AcheronProject/Apollo87H/(threads)

Thread 2 (2021-05-20):

Is this an A87 form factor?

dhanakane, 2021-05-20:
I’m hoping to use this as a drop in replacement for an H87c. Would it be suitable for this?

Gondolindrim, 2021-05-22:
Hello,

It was designed to be a replacement to H87/A87 PCBs. Please note that the compatibility list is still limited and I cannot guarantee fitness for a particular product (please read the license).

dhanakane, 2021-05-23:
Thank you. If you’ve got any tips on how to check for theoretical fit then that would be much appreciated. I’m assuming I can open up the PCB file in something like FreeCAD and look at the dimensions?

If the PCB footprint is the same as an H87, then it should work for my use case. Obviously, I understand this is all at my own risk.

Thanks for putting this project out there. I really appreciate the work!

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

Gondolindrim, 2021-05-25:
Confirmedly fits F1-84 by Geonworks

Gondolindrim, 2021-06-08:
> Thank you. If you’ve got any tips on how to check for theoretical fit then that would be much appreciated. I’m assuming I can open up the PCB file in something like FreeCAD and look at the dimensions?

> If the PCB footprint is the same as an H87, then it should work for my use case. Obviously, I understand this is all at my own risk.

> Thanks for putting this project out there. I really appreciate the work!

No problem!

There will be STEP files released soon, I just haven't had time to look at the weird error some of the LED footprints are giving me. If you have a 3D model of your case you should be able to test with the STEP if the PCB fits.

dhanakane, 2021-07-03:
Unfortunately I'm just a consumer and not a case designer. I'd be willing to order a prototype if the files to do so (gerber?) are made available, at my own risk obviously :)

Gondolindrim, 2021-07-04:
Prototypes for Apollo87H were already ordered -- if you'd like, you could order protos for Athena (solderable version of Apollo).

dhanakane, 2021-07-04:
Happy to do so if you can point me at the repo and files?

On Sun, 4 Jul 2021 at 20:58, Álvaro A. Volpato ***@***.***>
wrote:

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

Gondolindrim, 2021-07-08:
Athena is mid-development and I plan to release it by the end of the month.

Gondolindrim, 2022-05-17:
Closing this as prototypes were ordered and this PCB and Athena are confirmed H87 replacements.

Closed 2022-05-17.

Thread 4 (2025-08-19):

[PCB] Apollo87HL-T-SC 7u FR-4 Gray/1.6mm - No MT() Functionality in VIA

sleepbelts, 2025-08-19:
No MT() support in provided VIA firmware

Gondolindrim, 2025-08-20:
QMK documentation does not determine any particular firmware afjustment to make mod-tap enabled, so it should be fine... Can you reach me over at discord?

Closed 2025-08-20.
