AcheronProject/Apollo87H/(commit log)

2021-02-13 nAdded and routed RGB
    [apollo87h.kicad_sch]
2021-02-15 Routed SWD
    [apollo87h.kicad_sch]
2021-02-15 Advance routing
    [apollo87h.kicad_sch]
2021-02-16 DRC ran, issues fixed. Revised edges and pads to fit hoswap sockets better
    [apollo87h.kicad_sch]
2021-02-16 Finished routing, metadata update pending
    [apollo87h.kicad_sch]
2021-02-16 Added metadata to components
    [apollo87h.kicad_sch]
2021-02-16 Added label
    [apollo87h.kicad_sch]
2021-02-17 Added metadata for sheet and hotswap sockets
    [apollo87h.kicad_sch]
2021-02-17 Added Acheron Logo, minor trace adjustmentand no-net zones adjustments
    [apollo87h.kicad_sch]
2021-02-18 Preparing for release. Removed 'remove from bom' for hotswap sockets
    [apollo87h.kicad_sch]
2021-02-19 New KiCad version, first README version, Apollo logo added to resources
2021-03-05 Detachable USBC, JST connector
    [apollo87h.kicad_sch]
2021-03-17 Add HS standoffs for plate
    [apollo87h.kicad_sch]
2021-03-25 QOL upgrades
    - USB shielding ferrite bead was moved near the case grounding pad so as to make the ground copper pour more solid
    - Added extra RGB daugtherboard connector and a cable notch for passing the cable through
    - Added mechanical mousebit holes to make the USBC connector removable
    - Ran DRC, corrected minor errors
    [apollo87h.kicad_sch]
2021-03-25 Organize schematic
    [apollo87h.kicad_sch]
2021-03-25 Add specification metadata to components
    [apollo87h.kicad_sch]
2021-03-26 Remove 87HS file
    [apollo87h.kicad_sch]
2021-03-26 Cleanup for new RGB
    [apollo87h.kicad_sch]
2021-03-26 Setup RGB chip
    [apollo87h.kicad_sch]
2021-03-27 Place some LEDs, route some cols
    [apollo87h.kicad_sch]
2021-03-27 Add logo, reroute columns
    [apollo87h.kicad_sch]
2021-03-28 RGB routing
    [apollo87h.kicad_sch]
2021-03-28 Start routing RGB
    [apollo87h.kicad_sch]
2021-03-29 Add gitignore, more routing
    [apollo87h.kicad_sch]
2021-03-30 More RGB routing
    [apollo87h.kicad_sch]
2021-03-31 Further RGB routing
    [apollo87h.kicad_sch]
2021-04-01 Further RGB, 5V and 3V3 routing¨
    [apollo87h.kicad_sch]
2021-04-14 Features and QOL changes
    - Routed columns C14-C16
    - Added RGB daugherboard connector, routed RGB underglow circuit, and notch (hole) for RGB JST cable connection
    - Routed SWD pins and reset circuit
    - Changed RGB chip footprint to version with thermal relief vias on thermal pad
    - Routed bottom columns
    - Solved instances of unconnected traces
    - Exposed extra non-used pins
    - Made RGB chip unused pins floating and removed resistors
    [apollo87h.kicad_sch]
2021-04-16 Finish routing and run DRC
    - DRC ran, errors corrected
    - Routed column pins of the bottommost row RGB LEDs
    - Reorganized schematic
    - Changed RGB resistors for red LEDs to 51R
    - Filled void ground fill islands
    [apollo87h.kicad_sch]
2021-04-19 Change standoffs to 3.5mm tall version
    [apollo87h.kicad_sch]
2021-04-19 Added revision beta label
    [apollo87h.kicad_sch]
2021-04-19 Update component metadata
    [apollo87h.kicad_sch]
2021-04-23 Add Apollo87HS files
    - Apollo87HS files were introduced as a direct copy/fork of the v2.1.4/v2.1.3 version of 87H.
    [apollo87hs.kicad_sch]
2021-05-25 Silkscreen and documentation updates
2021-05-28 Remove stubs, update LED and socket 3D model paths
2021-05-28 Update USBC, reset button and fuse 3D models
2021-05-31 Solved reverse pinout for RGBA LEDs
    [apollo87h.kicad_sch]
2021-06-09 Trace cleanup
    [apollo87h.kicad_sch]
2021-06-13 Edit component metadata, final checks
    [apollo87h.kicad_sch]
2021-06-13 Remove 87HS files; will be stored in a new repository
    [apollo87hs.kicad_sch]
2021-06-13 Add metadata to some components; pre-release pending
    [apollo87h.kicad_sch]
2021-06-16 Expose pin B9, more DRC, few cleanups
    [apollo87h.kicad_sch]
2021-06-16 Small trace and designator adjustments
2021-06-26 Pre-revision Gamma design start
    - Update PCB constraints to metric up to Elecrow regular PCB specifications
    - Change label to pre-revision gamma
    [apollo87h.kicad_sch]
2021-06-27 Start routing
    - Added properties to copper pours
    - Edited relief cuts for JST connectors and ISSI chip
    - Routed USB connector area
    [apollo87h.kicad_sch]
2021-07-10 MCU swap, add components
    - MCU was swapped to an STM32F411, more available and cheaper
    - External EEPROM, crystal and voltage regulating MCU added
    - Minor re-routing needed
    [apollo87h.kicad_sch]
2021-07-22 Additional routing on back copper
    [apollo87h.kicad_sch]
2021-07-22 Start routing MCU/RGB controller
    [apollo87h.kicad_sch]
2021-07-22 Route some of the RGB SW's
    [apollo87h.kicad_sch]
2021-07-23 Reverse SW pins
    [apollo87h.kicad_sch]
2021-07-24 Start routing bottom row
    [apollo87h.kicad_sch]
2021-07-25 Further routing RGB bottom row
    [apollo87h.kicad_sch]
2021-07-26 Added renders, more routing
    [apollo87h.kicad_sch]
2021-07-28 Finish routing
    [apollo87h.kicad_sch]
2021-07-29 Better USB connector grounding
2021-07-30 Fix more DRC
    [apollo87h.kicad_sch]
2021-07-31 Add SPDT switches for BOOT0:1
    [apollo87h.kicad_sch]
2021-08-01 Add VBUS jumper for PA9 and expose it
    [apollo87h.kicad_sch]
2021-08-03 QOL upgrades, remove duplicate RGB
    [apollo87h.kicad_sch]
2021-08-05 QOL updates
    - RGB chip external resistance changed to 20k so maximum peak current is ~500mA
    - Small DRC fixes
    [apollo87h.kicad_sch]
2021-08-05 MCU multi-compatibility
    - Hybrid UFQFPN/LQFP-48 footprint
    [apollo87h.kicad_sch]
2021-08-06 QOL updates
    - RGB daughterboard notch is now a plated through-hole THT connected to ground
    - Minor trace fixes and stub removals
    - Added "BREAK HERE" indication on USBC connector break location
    [apollo87h.kicad_sch]
2021-08-21 QOL updates, add USB resistors
    - Minor tracing and copper pour improvements
    - Added resistor termination and pullup resistors for larger MCU compatibility
    [apollo87h.kicad_sch]
2021-08-22 QOL updates, DRC
    - Solve some "copper too close to edges" DRC errors
    - Solved "silkscreen too close to copper pads" DRC errors. New R0402 and C0402 footprints were needed
    - Exposed RGB daugherboard pins
    [apollo87h.kicad_sch]
2021-08-22 QOL updates, silksreen, USB rework
    - Tracing and VIAs adjustments
    - USB traces were reworked to better simmetry. The data lines were re-done and the USB pins were exposed, allowing for solderable cables. A D+ pullup was added for wider MCU compatibility. Some USB adjustments are still needed.
    - RGB pins were exposed in case the seller/manufacturer wants to omit the JST for RGB connection
    [apollo87h.kicad_sch]
2021-08-22 Rework RGB controller ground
    - The tracing around the RGB controller was reworked for better component placement and grounding
    [apollo87h.kicad_sch]
2021-08-22 Fix USB DB pinout
    [apollo87h.kicad_sch]
2021-08-24 USB rework, schematic reorganize
    - USB termination resistors were removed
    - USB D+ pullup resistor was moved from 5V to 3.3V
    - Schematic was reorganized and labels were reset
    [apollo87h.kicad_sch]
2021-09-03 Remove D+ to VBUS pullup
    [apollo87h.kicad_sch]
2021-09-03 Final DRC
    - Small errors corrected, mainly stubs and double vias
    [apollo87h.kicad_sch]
2021-09-03 Expose BOOT1 pin
2021-09-03 Update component metadata; pre-release version
    [apollo87h.kicad_sch]
2021-09-03 Update PCB layout and schematic versions on sheets
    [apollo87h.kicad_sch]
2021-10-12 Started updating outlines
    [apollo87h_preGamma_bom.csv, apollo87h_preGamma_posfile.csv]
2021-11-15 Minor corrections
    [apollo87h.kicad_sch]
2021-11-19 Adjust clearance on standoff holes
    [apollo87h.kicad_sch]
2021-11-19 Prepare for design of release Delta
    - Remove all traces
    - Change LED footprints ans symbols for SK6812 mini-E
    - Start routing mildly; major schematic reform pending (change MCU to 64-pin, change reset circuit, so on)
    [apollo87h.kicad_sch]
2021-11-22 Routing, Geon x Acheron logo
    [apollo87h.kicad_sch, apollo87h_preGamma_bom.csv, apollo87h_preGamma_posfile.csv]
2021-11-25 Add some filter circuits, reroutes in MCU rows
    [apollo87h.kicad_sch]
2021-11-27 Routing of RGB caps/resistors
    [apollo87h.kicad_sch]
2021-12-05 More routing, extra pins, SWD pins
    [apollo87h.kicad_sch]
2021-12-05 New label, finish routing, preparing for release
    [apollo87h.kicad_sch]
2021-12-05 Minor corrections, DRC pending
    [apollo87h.kicad_sch]
2021-12-05 Track errors corrections
2021-12-17 One-action reset circuit
    [apollo87h.kicad_sch]
2021-12-17 Better tracing for grounding integrity
    [apollo87h.kicad_sch]
2022-01-12 KiCAD version, routing
    - New KiCAD 6.0.0 version
    - Routing and DRC improvements
    [apollo87h.kicad_sch]
2022-01-25 DRC ran, issues corrected. Prepare for release
    [apollo87h.kicad_sch]
2022-01-25 New tag
    [apollo87h.kicad_sch]
2022-01-25 Edit component metadata
    [apollo87h.kicad_sch, apollo87h_delta-rc1_bom.csv]
2022-04-12 QoL routing updates, relabel components
    [apollo87h.kicad_sch, apollo87h_delta-rc1_bom.csv]
2022-04-12 Add component metadata
    [apollo87h.kicad_sch]
2022-04-12 Add component metadata; preparing for release
    [apollo87h.kicad_sch]
